TueTran2008/DualSlopeADC-Thietkethietbido/README.md

# DualSlopeADC-Thietkethietbido
 Tham khảo: https://github.com/dangmanhtruong1995/8051
