TueTran2008/DualSlopeADC-Thietkethietbido/ADC_DUAL_SLOPE_SIMULATION/ADC dual slope/README.txt

FILE MÔ phỏng : ADC_DUAL_SLOPE_SIMULATION
CODE MÔ phỏng : Voltage_Current_Sensing_Without_ADC 
Hex file nạp cho 8051 : test.hex
