TueTran2008/DualSlopeADC-Thietkethietbido/SCHEMATIC_&PCBDESIGN/ADC_Dual_Slope.pdf

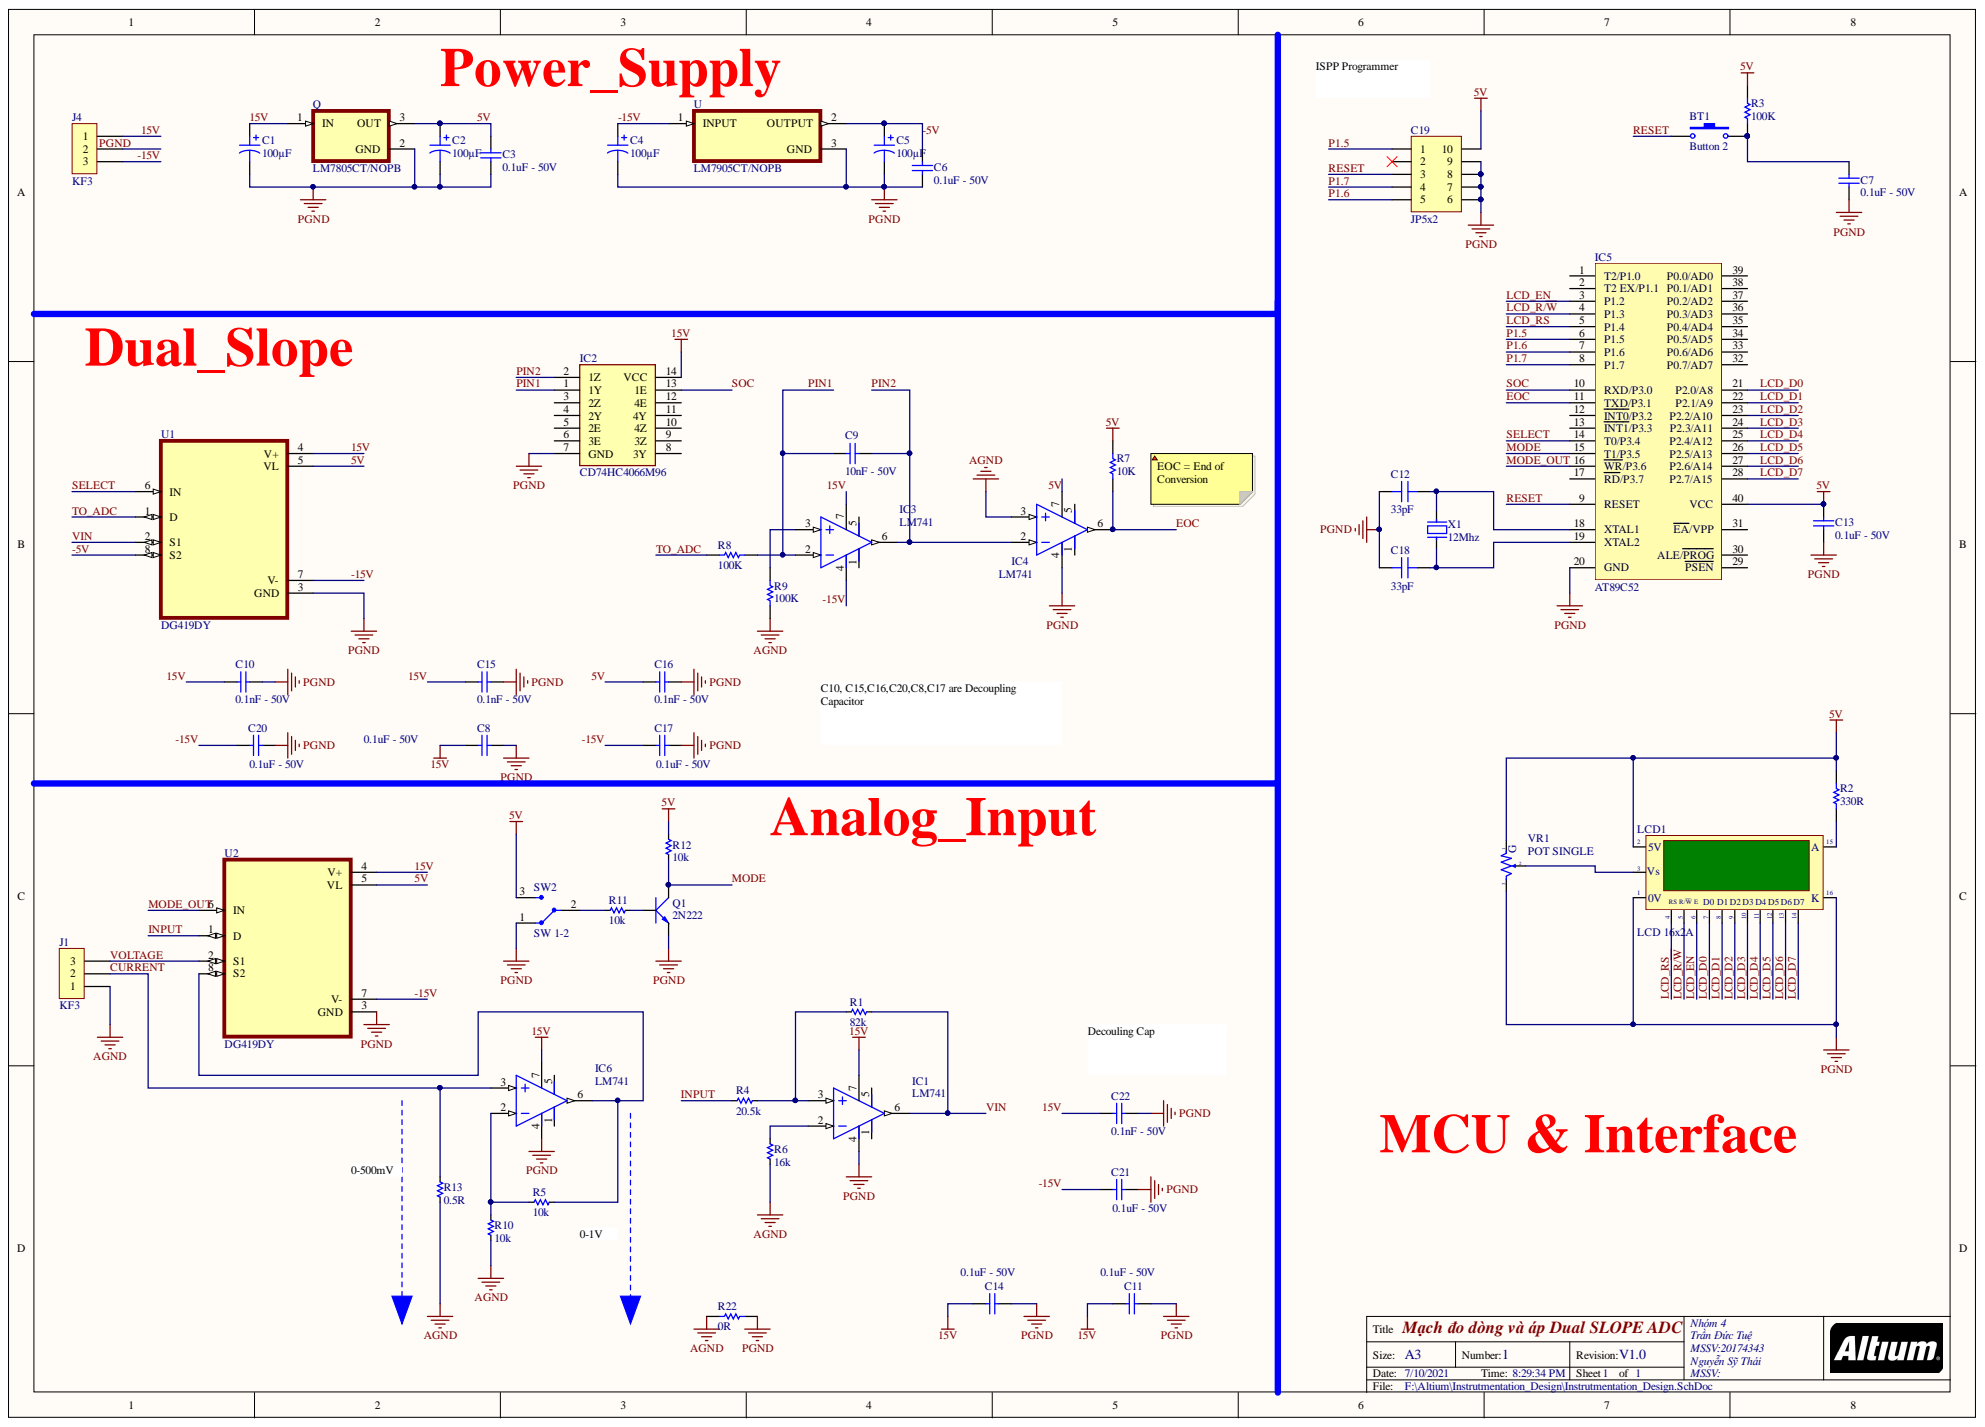
[picture p19: page 1]

Mạch đo dòng và áp Dual SLOPE ADC Title | Nhóm 4 Trần Đức Tuệ MSSV:20174343 Nguyễn Sỹ Thái MSSV:

Size: A3 | Number: 1 | Revision: V1.0

Date: 7/10/2021 Time: 8:29:34 PM | | Sheet 1 of 1

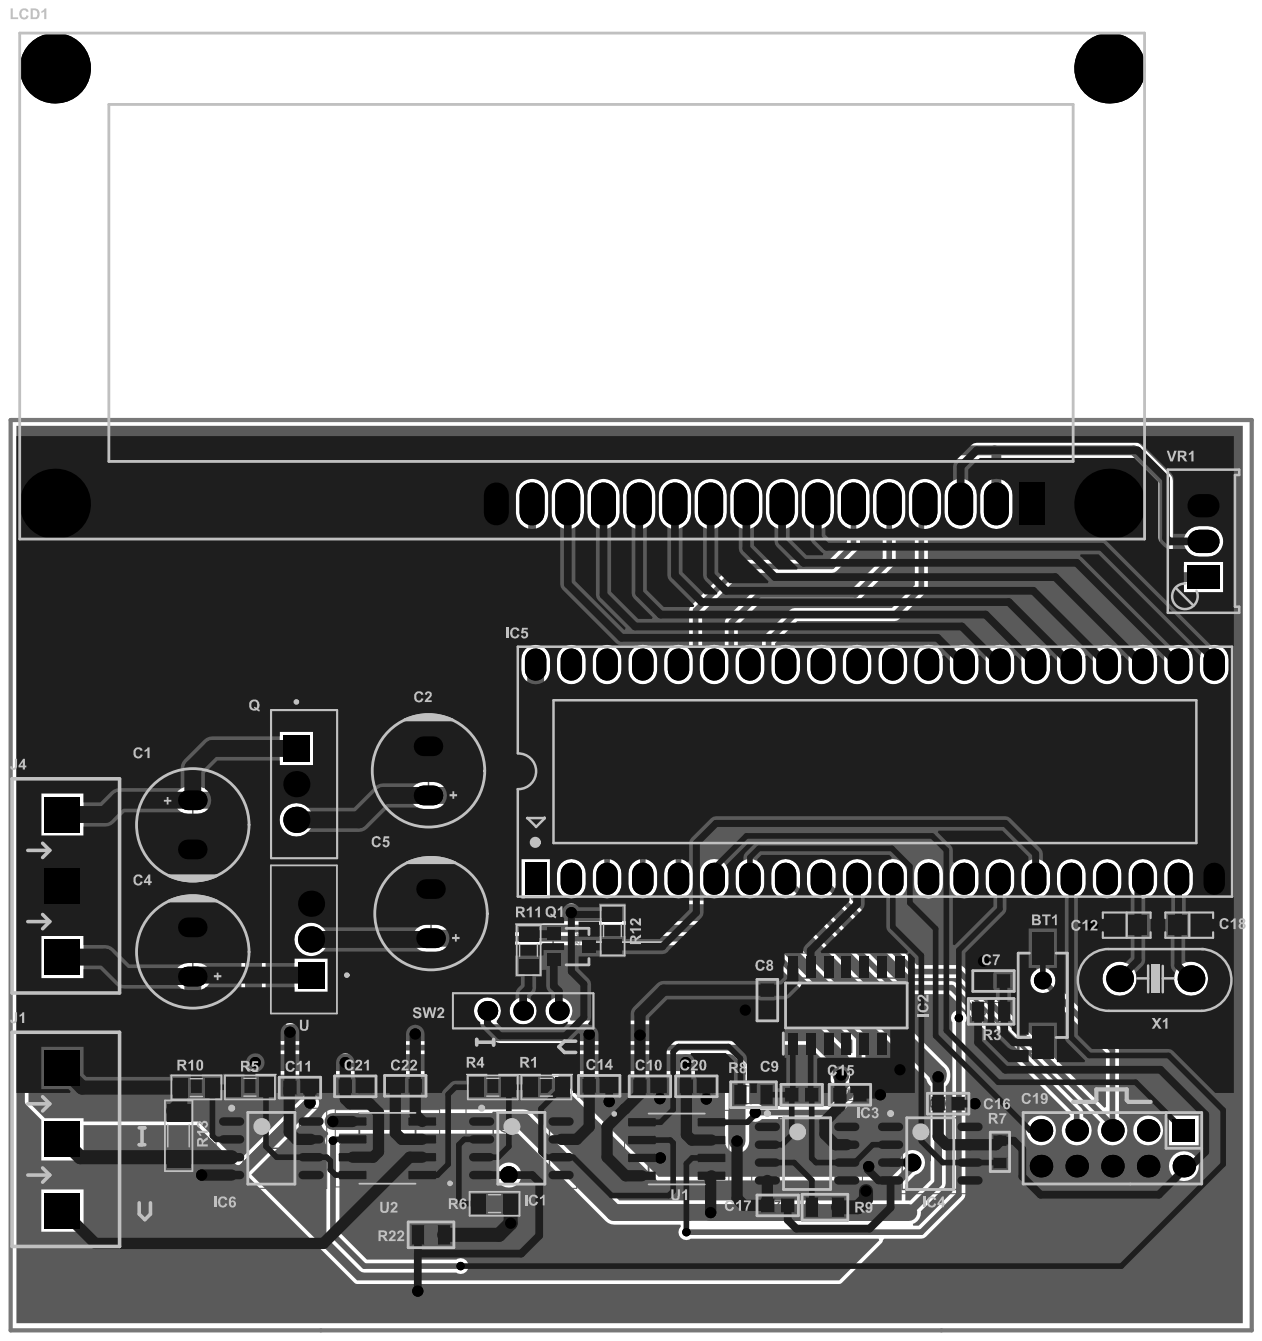
[picture p20: page 2]

# Board Stack
