TueTran2008/DualSlopeADC-Thietkethietbido/(list of files, drawings)

Other design files:
ADC_DUAL_SLOPE_SIMULATION/ADC dual slope/ADC_DUAL_SLOPE_SIMILATION.pdsprj
SCHEMATIC_&PCBDESIGN/ADC_Dual_Slope.PrjPCB
SCHEMATIC_&PCBDESIGN/Instrutmentation_Design.SchDoc
SCHEMATIC_&PCBDESIGN/Voltage_Current.PcbDoc
